newrps/fsd/(commit log)

2026-05-09 Initial commit: fsd Rust workspace (jetson + firmware + ml + cad + docs)
    - Rust workspace: protocol, jetson (tokio), ml (burn)
    - STM32 H753ZI firmware (Embassy, no_std)
    - Python ML pipeline (PyTorch + ONNX export)
    - CadQuery + OpenSCAD 3D mount parts
    - Comprehensive docs (hardware, setup, deployment, troubleshooting)
    - GitHub Actions CI workflow
    [assembly.scad, camera_mast.scad, cover_shell.scad, jetson_tray.scad, params.scad, stm32_clip.scad, top_deck.scad]
2026-05-09 fix(firmware): set ADC mux to PER to avoid PLL2_P dependency
    ADC1 was defaulting to pll2_p clock which wasn't enabled in RCC config,
    causing immediate panic on boot:
    'peripheral ADC1 is configured to use the pll2_p clock,
    which is not running'
    Switch ADCSEL to PER (HSI 64MHz, already enabled). ADC sampling
    frequency lands at 32MHz, well within the 80MHz spec.
    Verified on NUCLEO-H753ZI: boots cleanly, all tasks spawned.
    [main.rs]
2026-05-09 docs: record Jetson Orin Nano Super setup and NUCLEO firmware first flash
    CHANGELOG.md (2026-05-09):
    - Jetson environment setup complete (JetPack 6.2.2, NVMe boot)
    - GitHub repo created and initial push done
    - Jetson-side cargo build verified
    - Firmware ADC clock bug fix
    - NUCLEO-H753ZI first flash completed
    firmware.md:
    - Add 'one-line summary' and '8 features at a glance' tables
    - Add 'flash verification' section with expected RTT output and LED diagnostic table
    - Add 'RCC config notes' explaining the ADC mux (PER vs pll2_p)
    troubleshooting.md:
    - Expand 'No probe found' with LED-based hardware diagnostic
    - Add new entry for the 'pll2_p clock not running' boot panic
2026-05-09 feat(firmware): switch USART3 from PD8/PD9 to PB10/PB11 (Zio CN10 D36/D35)
    NUCLEO-H753ZI MB1364 의 morpho 헤더 (CN11/CN12) 가 출고 시 미솔더링이라
    PD8/PD9 외부 접근 불가. PB10/PB11 은 Zio CN10 (이미 솔더링) 의
    핀 32/34 (D36/D35 라벨) 로 노출되어 점퍼 와이어 직결 가능.
    연결도:
    Jetson J12 pin 8 (UART_TX) -> NUCLEO CN10 pin 34 (PB11 RX)
    Jetson J12 pin 10 (UART_RX) <- NUCLEO CN10 pin 32 (PB10 TX)
    Jetson J12 pin 6 (GND) <-> NUCLEO CN10 pin 9 (GND)
    NUCLEO-H753ZI 실측 부팅 정상 (PB10/PB11 init OK).
2026-05-09 wip(firmware): debug logs for stuck task polling + datasheet/vender ignore
    NUCLEO 펌웨어가 spawn 까진 정상이지만 executor 가 이후 task 를
    poll 하지 않는 이슈를 추적하기 위한 디버그 로그 추가:
    - main() 의 LD1 sanity check
    - 각 spawn 호출 사이의 info! 로그
    - battery_task 일시 비활성화 (ADC blocking_read starvation 의심)
    - time-driver-tim2 -> time-driver-any 교체
    상태: heartbeat task 의 'STARTED' 로그도 찍히지 않음 = task fn body
    진입 자체를 못 함. embassy-executor 0.10 + embassy-stm32 0.6 호환성
    문제로 의심. 추후 0.7 다운그레이드 또는 executor 메뉴얼 셋업으로 검증.
    .gitignore: 다운로드한 P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
    [main.rs]
2026-05-09 wip(firmware): more debug on stuck task polling, revert to baseline
    추가 디버깅: main 끝에 Timer::after 무한 루프 추가해서 main 도 task 로
    keep-alive 시도. 결과: main 의 'main alive 0' 도 출력 안 됨 = Timer::after
    자체가 resolve 안 됨. 시간 드라이버가 task wake 신호 안 보내는 이슈로 확정.
    다음 세션 시도 옵션:
    1) embassy 0.6/0.10 호환 minimal blink 예제 작성해서 환경 검증
    2) time-driver-tim3 또는 다른 타이머 시도
    3) embassy-time-queue-utils integrated-timers 명시 활성화
    4) embassy 생태계 전체 다른 버전 셋 (예: stm32 0.5 + executor 0.7)
    베이스라인 복원: time-driver-tim2.
    [main.rs]
2026-05-09 feat(firmware): Jetson↔NUCLEO 시리얼 통신 검증 (ST-LINK VCP)
    USART3 PD8/PD9 → ST-LINK USB-VCP → Jetson /dev/ttyACM0 양방향 통신 검증 완료
    (50Hz 텔레메트리 수신 + 100Hz cmd 송신, last_applied_seq 증가).
    핵심 변경:
    - firmware: USART3 PD8/PD9 + 115200 baud, step5 통신 검증용 simplified
    (EXTI/ADC task 는 main.rs.bak 보존 — 다음 단계에서 재활성화)
    - Cargo.toml: time-driver-any + executor-interrupt 복원, embassy-sync 0.8
    (embassy-stm32 0.6 호환). 이전 task polling 미동작 이슈 종결.
    - 점퍼와이어 직결 시도 (Zio CN10 / morpho CN12) → default SB 라우팅 +
    핀 식별 어려움으로 실패. ST-LINK VCP 가 NUCLEO-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
2026-05-09 feat(firmware): 9-task 구조 복원 + RC/encoder/battery 비활성 가이드
    step5 통신 검증 후 원본 main.rs.bak 기반 9-task 구조 복원. USART3 PD8/PD9
    + 115200 baud 는 ST-LINK VCP 경로 유지.
    - firmware: heartbeat/safe_indicator/uart_rx/pwm/telemetry 5 task 활성,
    rc_capture × 2 / encoder / battery 4 task 는 #[allow(dead_code)] +
    main 의 commented 블록으로 비활성. 결선 후 활성화 가이드 주석 추가.
    - 디버깅 결과 (2026-05-10): RC 수신기 / 엔코더 미결선 상태에서
    ExtiInput::new + bind_interrupts!{EXTI0/1/2} 활성 시 floating-like
    입력의 환경 노이즈로 IRQ 폭주 → executor task polling 정지.
    단계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
2026-05-10 docs: 부품 도착 후 재개 가이드 + ml 파이프라인 검증 결과
    부품 (수-암 점퍼/빵판/멀티미터/저항) 대기 동안 컨텍스트 손실 없이
    이어 작업할 수 있도록 단계별 절차 정리.
    - docs/resume-after-parts.md (신규): 7 단계 (NUCLEO↔서보/ESC 결선
    → bench 테스트 → RC 수신기 + EXTI 활성화 → 엔코더 → 배터리 분배기
    → 카메라 → ml 학습 + 자율주행). 각 단계 결선/명령/예상 결과/
    트러블슈팅 포함.
    - docs/README.md: resume-after-parts.md 링크.
    - docs/CHANGELOG.md: ml-py 파이프라인 검증 결과 entry 추가
    (smoke MAE_s 0.12 / compare_archs tiny 우승 / drive_sim 151 frame
    /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
